nrjimenez/Camera-Field-Controller/Photos/Controller_InsideComponent_Labels.PNG

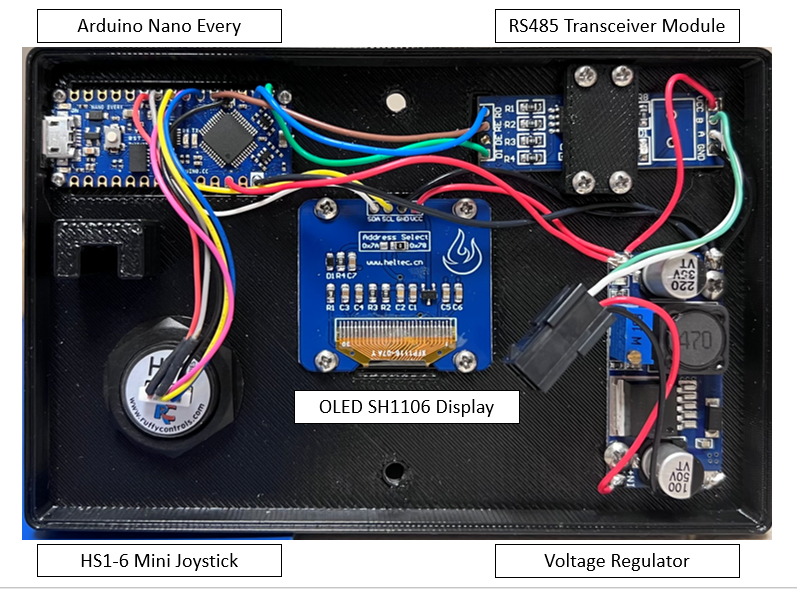
Photos/Controller_InsideComponent_Labels.PNG
