nrjimenez/Camera-Field-Controller/Photos/Controller_InsideBack.jpg

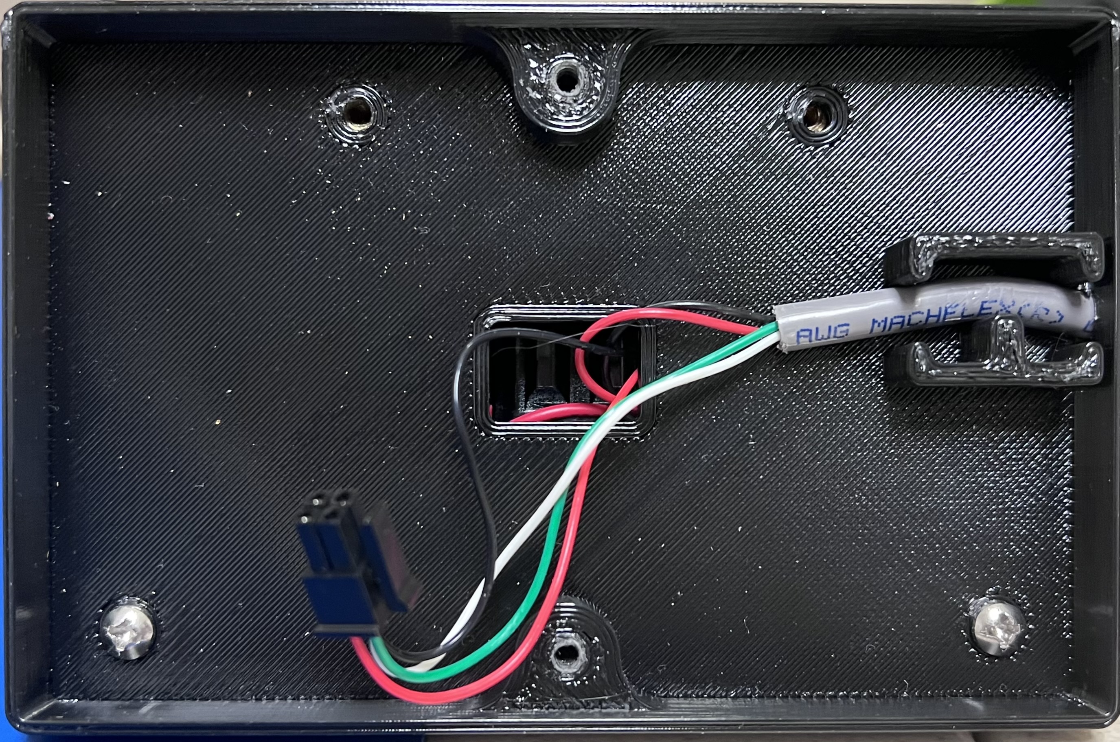
Photos/Controller_InsideBack.jpg
