nrjimenez/Camera-Field-Controller/Photos/Controller_BatteryMount.jpg

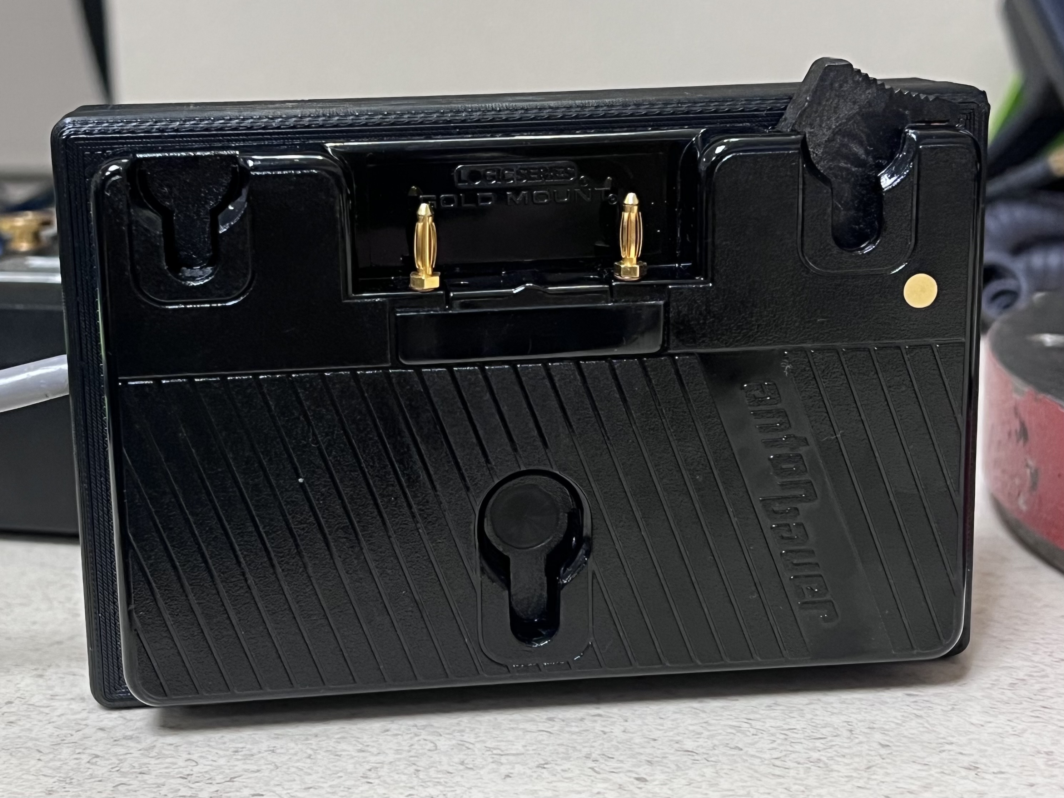
Photos/Controller_BatteryMount.jpg
