nrjimenez/Camera-Field-Controller/Photos/Controller_InsideFront.jpg

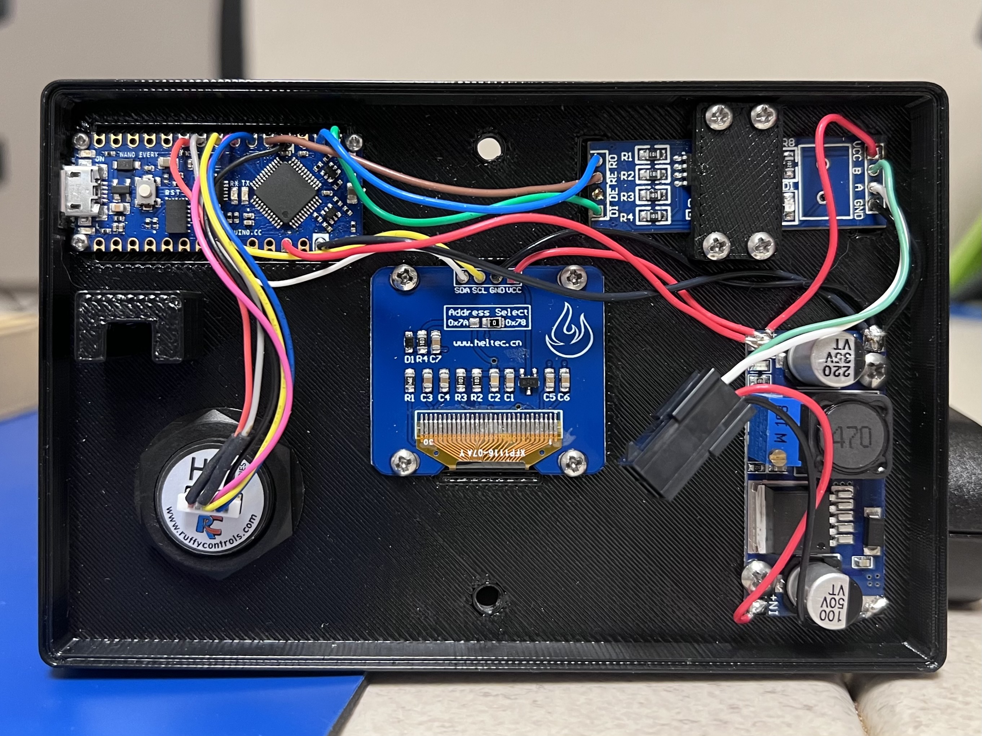
Photos/Controller_InsideFront.jpg
