nrjimenez/Camera-Field-Controller/Photos/Controller_menu_on.jpg

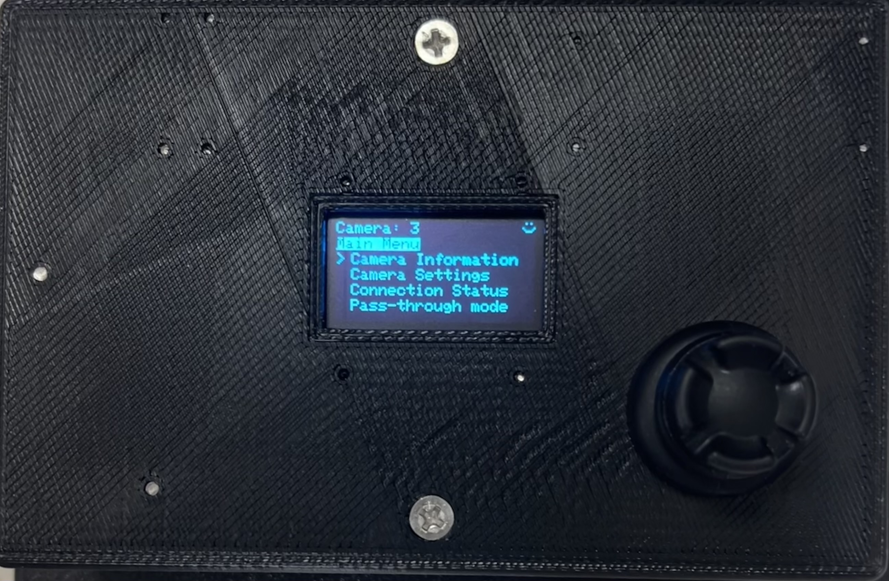
Photos/Controller_menu_on.jpg
