nrjimenez/Camera-Field-Controller/Photos/Controller_Side.jpg

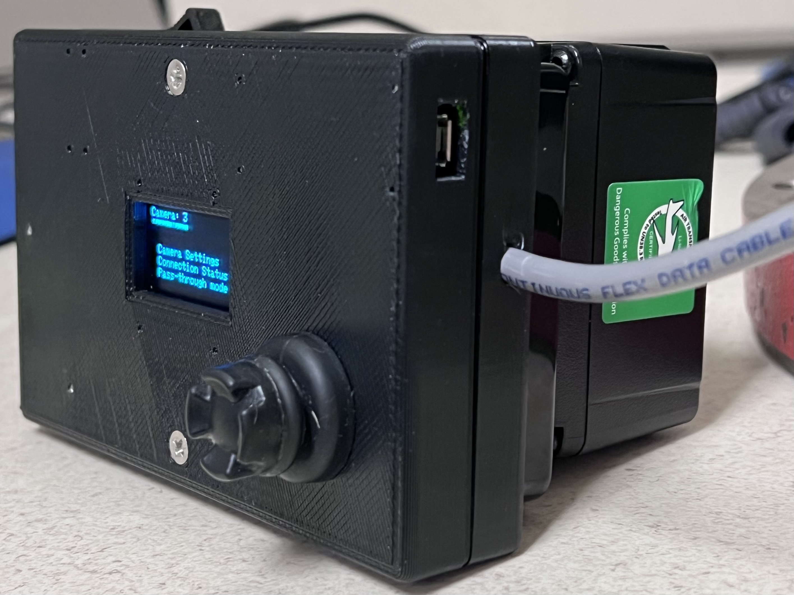
Photos/Controller_Side.jpg
