nrjimenez/Camera-Field-Controller/(list of files, cad)

Other CAD files:
Mechanical/AssemblyUpdated.iam
Mechanical/Controller_Back.ipt
Mechanical/Controller_Front.ipt
Mechanical/Controller_Strap.ipt
