nrjimenez/Camera-Field-Controller/DreamChip_Field_Controller/src/splash.h

const unsigned char SPLASH [] PROGMEM = {
    0xff, 0xff, 0xff, 0xff, 0xff, 0xff, 0xff, 0xff, 0xff, 0xff, 0xff, 0xff, 0xff, 0xff, 0xff, 0xff, 
    0xff, 0xff, 0xff, 0xff, 0xff, 0xff, 0xff, 0xff, 0xff, 0xff, 0xff, 0xff, 0xff, 0xff, 0xff, 0xff, 
    0xff, 0xff, 0xff, 0xff, 0xff, 0xff, 0xff, 0xff, 0xff, 0xff, 0xff, 0xff, 0xff, 0xff, 0xff, 0xff, 
    0xff, 0xff, 0xff, 0xff, 0xff, 0xff, 0xff, 0xff, 0xff, 0xff, 0xff, 0xff, 0xff, 0xff, 0xff, 0xff, 
    0xff, 0xff, 0xff, 0xff, 0xff, 0xff, 0xff, 0xff, 0xff, 0xff, 0xff, 0xff, 0xff, 0xff, 0xff, 0xff, 
    0xff, 0xff, 0xff, 0xc0, 0x0e, 0x03, 0xff, 0x07, 0xf8, 0x03, 0x00, 0x1f, 0xff, 0xff, 0xff, 0xff, 
    0xff, 0xff, 0xff, 0xc0, 0x06, 0x03, 0xff, 0x07, 0xf0, 0x03, 0x00, 0x1f, 0xff, 0xff, 0xff, 0xff, 
    0xff, 0xff, 0xff, 0xf1, 0xc3, 0x8f, 0xfe, 0x03, 0xe1, 0xe3, 0xc3, 0x1f, 0xff, 0xff, 0xff, 0xff, 
    0xff, 0xff, 0xff, 0xf1, 0xc3, 0x8f, 0xfe, 0x43, 0xc3, 0xe3, 0xc3, 0xff, 0xff, 0xff, 0xff, 0xff, 
    0xff, 0xff, 0xff, 0xf0, 0xc3, 0x8f, 0xfc, 0x43, 0xc3, 0xff, 0xc0, 0x7f, 0xff, 0xff, 0xff, 0xff, 
    0xff, 0xff, 0xff, 0xf0, 0x07, 0x8f, 0xfc, 0x61, 0xc3, 0xff, 0xc0, 0x3f, 0xff, 0xff, 0xff, 0xff, 
    0xff, 0xff, 0xff, 0xf0, 0x1f, 0x8f, 0xf8, 0x01, 0xc3, 0xff, 0xc0, 0x7f, 0xff, 0xff, 0xff, 0xff, 
    0xff, 0xff, 0xff, 0xf1, 0xff, 0x8f, 0xf8, 0x01, 0xc1, 0xff, 0xc3, 0xff, 0xff, 0xff, 0xff, 0xff, 
    0xff, 0xff, 0xff, 0xf1, 0xff, 0x8e, 0x30, 0xf0, 0xe0, 0xfb, 0xc3, 0x8f, 0xff, 0xff, 0xff, 0xff, 
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
    0xff, 0xff, 0xff, 0xff, 0xff, 0xff, 0xff, 0xff, 0xff, 0xff, 0xff, 0xff, 0xff, 0xff, 0xff, 0xff, 
    0xff, 0xff, 0xff, 0xff, 0x03, 0x03, 0x00, 0x38, 0x07, 0xe0, 0x03, 0xff, 0xff, 0xff, 0xff, 0xff, 
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
};
