nrjimenez/Camera-Field-Controller/DreamChip_Field_Controller/src/icons.h

const unsigned char smileBig[] PROGMEM = {
  0x00, 0x00, 0x0c, 0x30, 0x0c, 0x30, 0x00, 0x00, 0x00, 0x00, 0x00, 0x00, 0x00, 0x00,
  0x60, 0x06, 0x30, 0x0c, 0x18, 0x18, 0x0f, 0xf0, 0x07, 0xe0
};

const unsigned char frownBig[] PROGMEM = {
  0x00, 0x00, 0x0c, 0x30, 0x0c, 0x30, 0x00, 0x00, 0x00, 0x00, 0x00, 0x00, 0x00, 0x00,
  0x07, 0xe0, 0x0f, 0xf0, 0x18, 0x18, 0x30, 0x0c, 0x60, 0x06
};

const unsigned char smile[] PROGMEM = {
  0x24, 0x00, 0x00, 0x81, 0x42, 0x3c
};

const unsigned char frown[] PROGMEM = {
  0x24, 0x00, 0x00, 0x3c, 0x42, 0x81
};
